appltini/arduino-obstacle-avoidance-robot/screenshots/image2.jpg

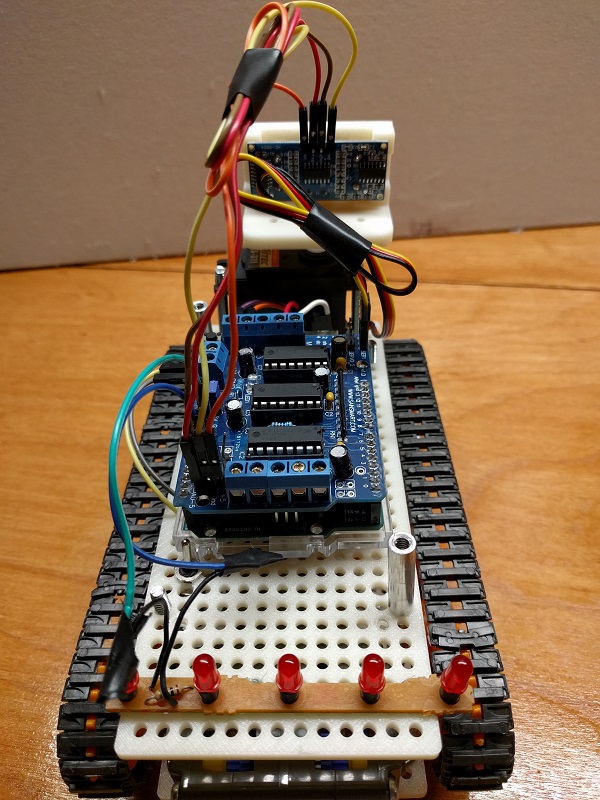
screenshots/image2.jpg
